cyfinfaza/RSC-LV3-HVBPS/(list of files, drawings)

Other design files:
RSC-LV3-HVBPS.dsn
