cyfinfaza/RSC-LV3-HVBPS/RSC-LV3-HVBPS.kicad_pcb

## KiCad design RSC-LV3-HVBPS.kicad_pcb (2026-06-22)

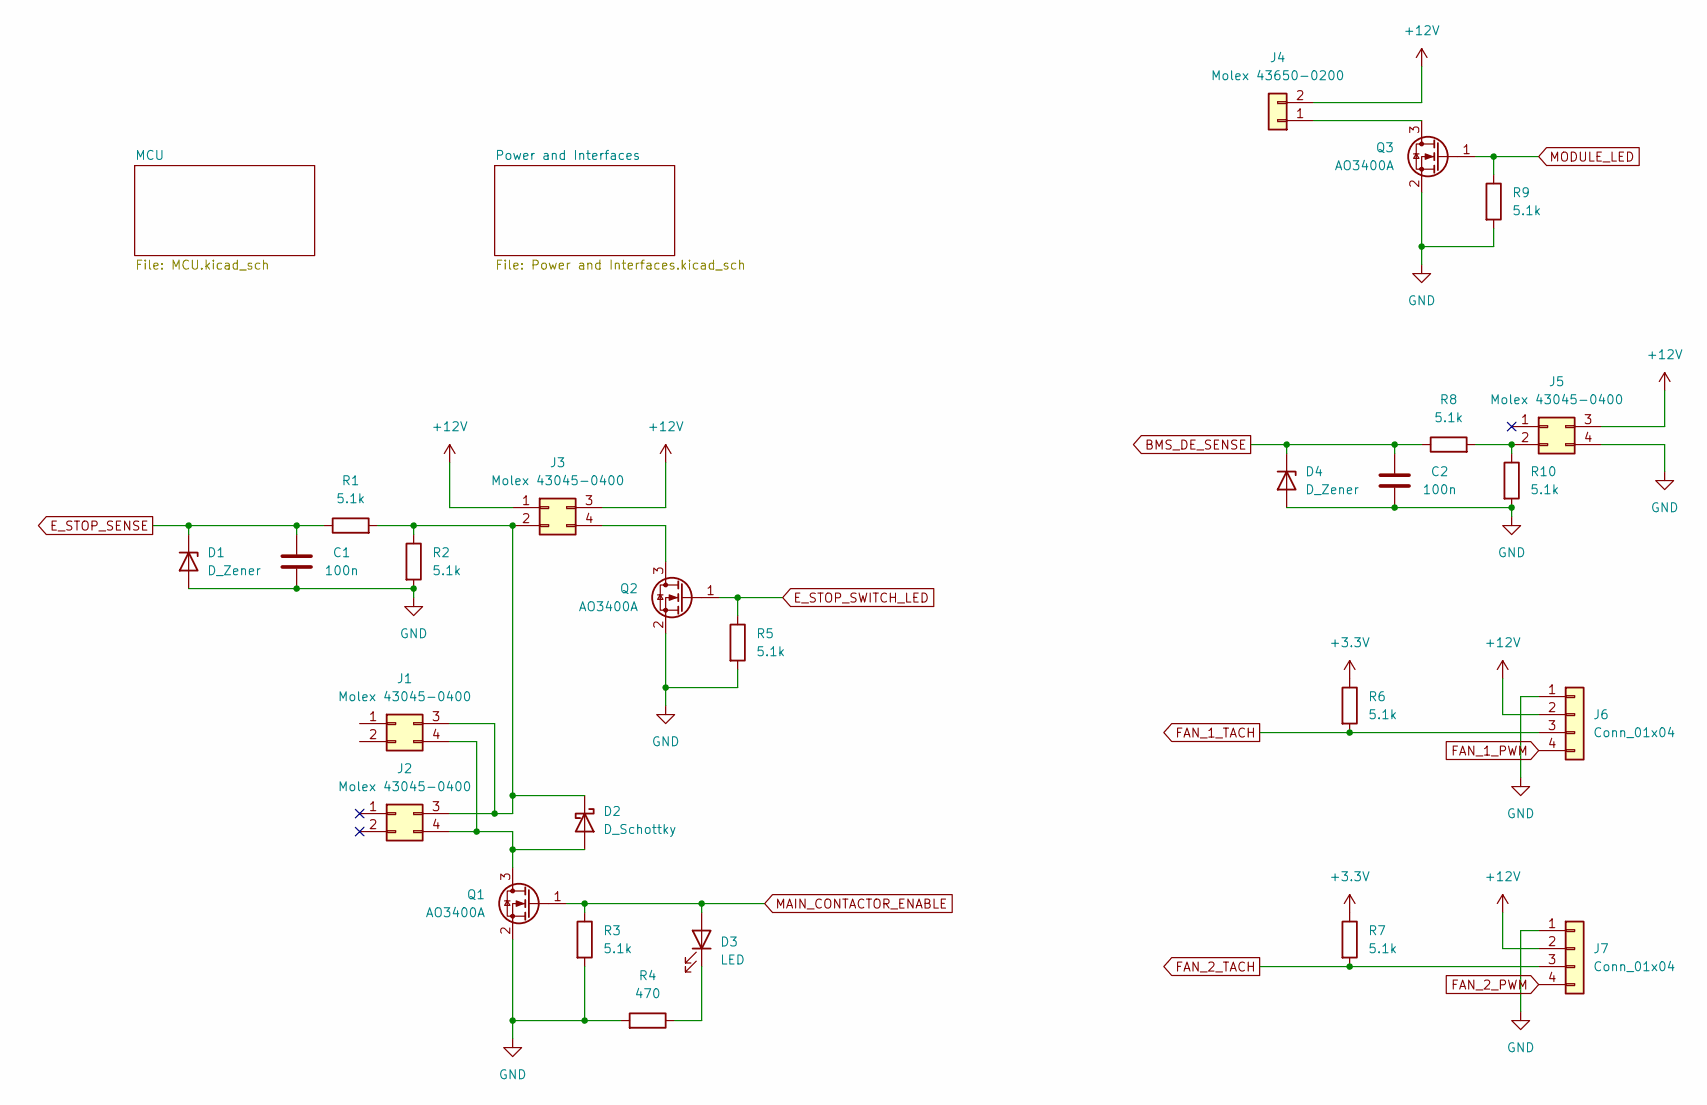
[picture p1: schematic RSC-LV3-HVBPS.kicad_sch]

Parts:
C1, C2: 100n; C_0603_1608Metric_Pad1.08x0.95mm_HandSolder
D1, D4: D_Zener; D_SOD-323_HandSoldering
D2: D_Schottky; D_SOD-123F
D3: LED; LED_0603_1608Metric_Pad1.05x0.95mm_HandSolder
J1, J2, J3, J5: Molex 43045-0400; Molex_Micro-Fit_3.0_43045-0412_2x02_P3.00mm_Vertical
J4: Molex 43650-0200; Molex_Micro-Fit_3.0_43650-0215_1x02_P3.00mm_Vertical
J6, J7: Conn_01x04; Molex_KK-254_AE-6410-04A_1x04_P2.54mm_Vertical
Q1, Q2, Q3: AO3400A; SOT-23
R1, R2, R3, R5, R6, R7, R8, R9, R10: 5.1k; R_0603_1608Metric_Pad0.98x0.95mm_HandSolder
R4: 470; R_0603_1608Metric_Pad0.98x0.95mm_HandSolder

Connections:
+3.3V: R6.1, R7.1; also elsewhere on the board
+12V: J3.1, J3.3, J4.2, J5.3, J6.2, J7.2; also elsewhere on the board
BMS_DE_SENSE: C2.1, D4.1 (K), R8.1; also elsewhere on the board
E_STOP_SENSE: C1.1, D1.1 (K), R1.1; also elsewhere on the board
E_STOP_SWITCH_LED: Q2.1 (G), R5.1; also elsewhere on the board
FAN_1_PWM: J6.4; also elsewhere on the board
FAN_1_TACH: J6.3, R6.2; also elsewhere on the board
FAN_2_PWM: J7.4; also elsewhere on the board
FAN_2_TACH: J7.3, R7.2; also elsewhere on the board
GND: C1.2, C2.2, D1.2 (A), D4.2 (A), J5.4, J6.1, J7.1, Q1.2 (S), Q2.2 (S), Q3.2 (S), R2.2, R3.2, R4.2, R5.2, R9.2, R10.2; also elsewhere on the board
MAIN_CONTACTOR_ENABLE: D3.2 (A), Q1.1 (G), R3.1; also elsewhere on the board
MODULE_LED: Q3.1 (G), R9.1; also elsewhere on the board
unnamed: D2.2 (A), J1.4, J2.4, Q1.3 (D)
unnamed: D2.1 (K), J1.3, J2.3, J3.2, R1.2, R2.1
unnamed: D3.1 (K), R4.1
unnamed: J3.4, Q2.3 (D)
unnamed: J4.1, Q3.3 (D)
unnamed: J5.2, R8.2, R10.1

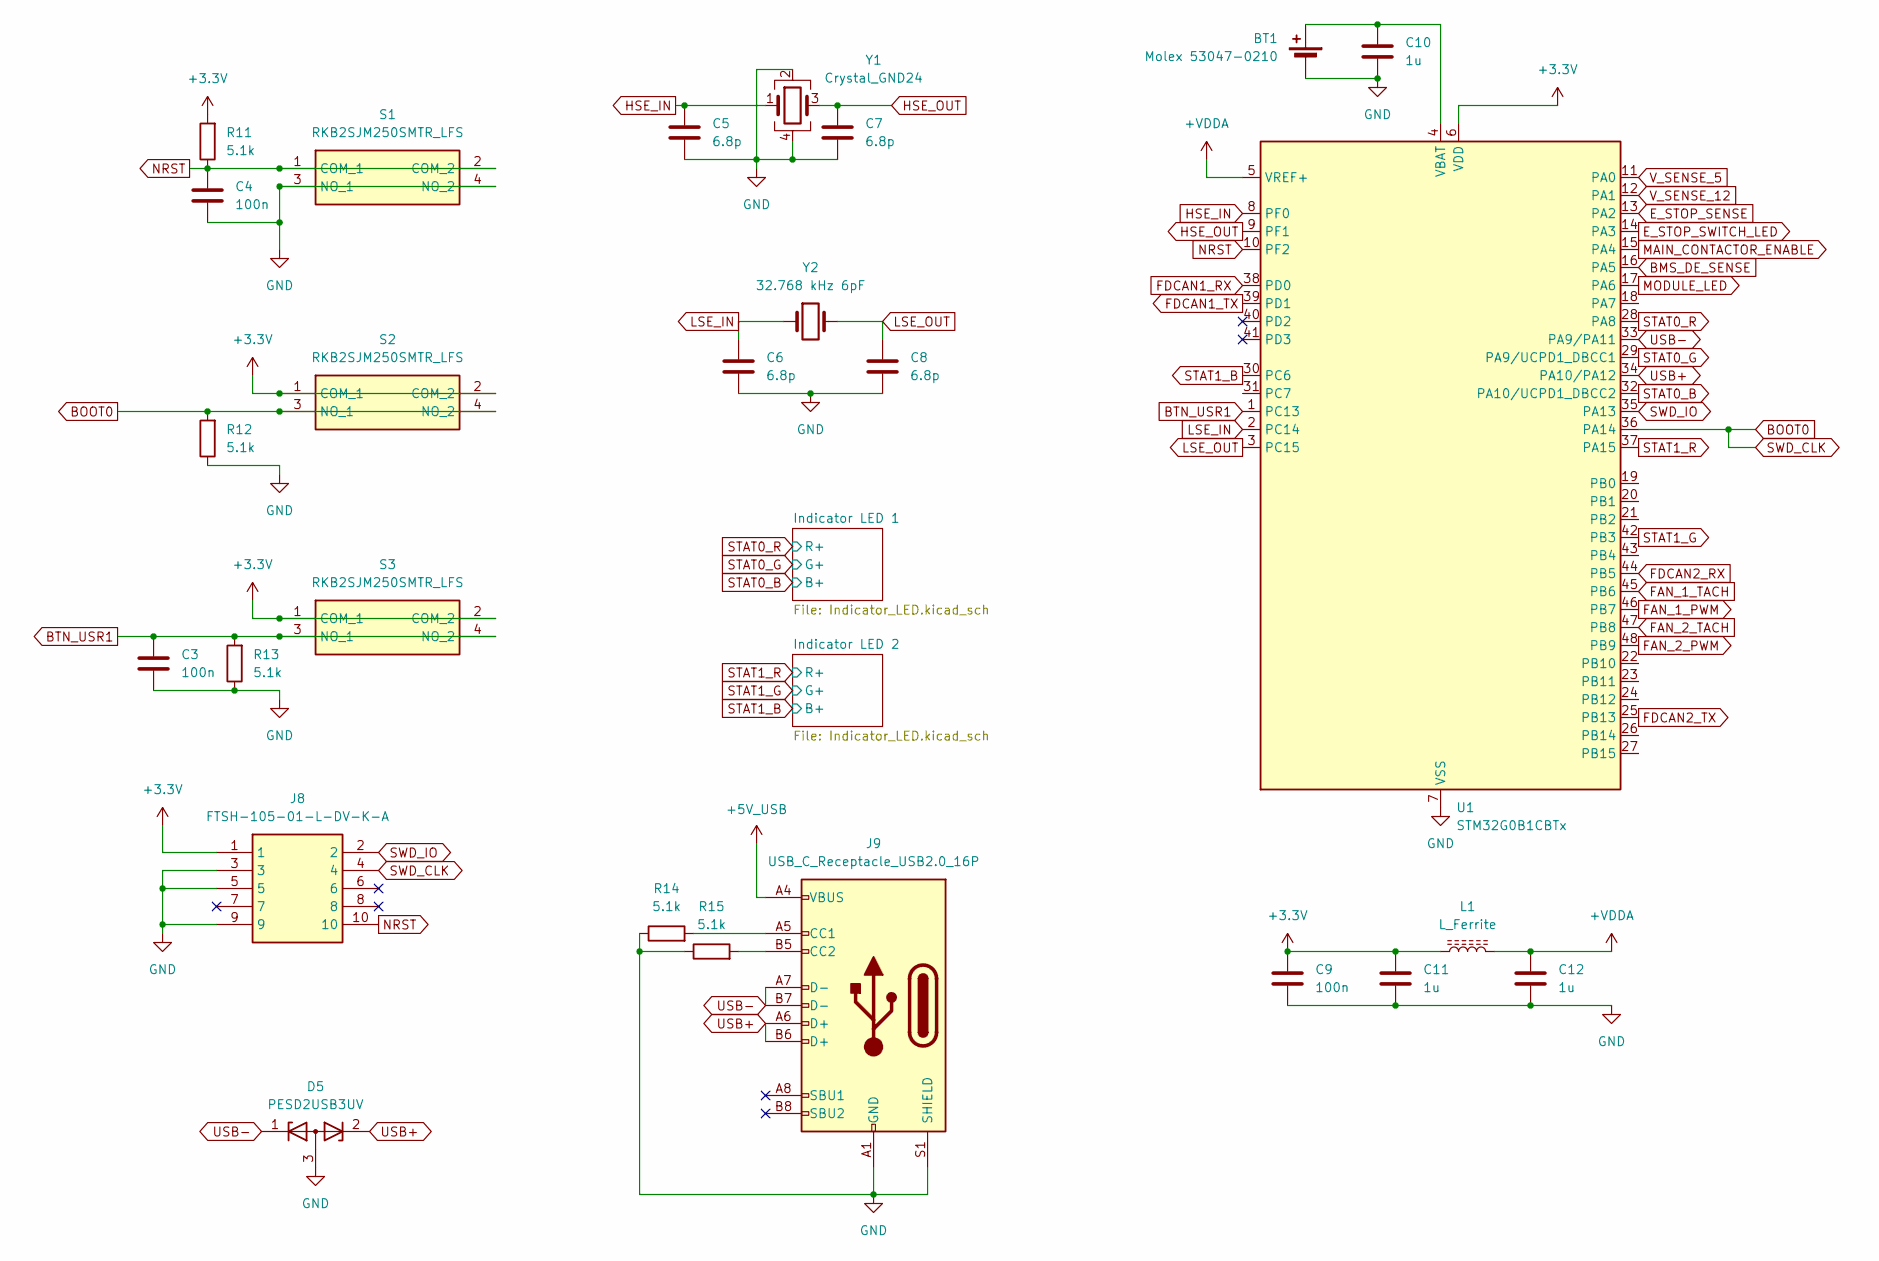
[picture p2: schematic MCU.kicad_sch]

Parts:
BT1: Molex 53047-0210; Molex_PicoBlade_53047-0210_1x02_P1.25mm_Vertical
C3, C4, C9: 100n; C_0603_1608Metric_Pad1.08x0.95mm_HandSolder
C5, C6, C7, C8: 6.8p; C_0603_1608Metric_Pad1.08x0.95mm_HandSolder
C10, C11, C12: 1u; C_0603_1608Metric_Pad1.08x0.95mm_HandSolder
D5: PESD2USB3UV; SOT-23W
J8: FTSH-105-01-L-DV-K-A; FTSH-105-XX-YYY-DV-K-A; Mouser Part Number 200-FTSH10501LDVKA
J9: USB_C_Receptacle_USB2.0_16P; USB_C_Receptacle_HRO_TYPE-C-31-M-12
L1: L_Ferrite; L_0603_1608Metric_Pad1.05x0.95mm_HandSolder
R11, R12, R13, R14, R15: 5.1k; R_0603_1608Metric_Pad0.98x0.95mm_HandSolder
S1, S2, S3: RKB2SJM250SMTR_LFS; RKB2SJM250SMTRLFS; Mouser Part Number 611-RKB2SJM250SMTRLF
U1: STM32G0B1CBTx; LQFP-48_7x7mm_P0.5mm
Y1: Crystal_GND24; Crystal_SMD_3225-4Pin_3.2x2.5mm
Y2: 32.768 kHz 6pF; Crystal_C26-LF_D2.1mm_L6.5mm_Horizontal

Connections:
+3.3V: C9.1, C11.1, J8.1, L1.1, R11.2, S2.1 (COM_1), S2.2 (COM_2), S3.1 (COM_1), S3.2 (COM_2), U1.6 (VDD); also elsewhere on the board
+5V_USB: J9.A4 (VBUS), J9.A9 (VBUS), J9.B4 (VBUS), J9.B9 (VBUS); also elsewhere on the board
+VDDA: C12.1, L1.2, U1.5 (VREF+)
BMS_DE_SENSE: U1.16 (PA5); also elsewhere on the board
BOOT0: J8.4, R12.2, S2.3 (NO_1), S2.4 (NO_2), U1.36 (PA14)
BTN_USR1: C3.1, R13.2, S3.3 (NO_1), S3.4 (NO_2), U1.1 (PC13)
E_STOP_SENSE: U1.13 (PA2); also elsewhere on the board
E_STOP_SWITCH_LED: U1.14 (PA3); also elsewhere on the board
FAN_1_PWM: U1.46 (PB7); also elsewhere on the board
FAN_1_TACH: U1.45 (PB6); also elsewhere on the board
FAN_2_PWM: U1.48 (PB9); also elsewhere on the board
FAN_2_TACH: U1.47 (PB8); also elsewhere on the board
FDCAN1_RX: U1.38 (PD0); also elsewhere on the board
FDCAN1_TX: U1.39 (PD1); also elsewhere on the board
FDCAN2_RX: U1.44 (PB5); also elsewhere on the board
FDCAN2_TX: U1.25 (PB13); also elsewhere on the board
GND: BT1.2 (-), C3.2, C4.2, C5.2, C6.2, C7.2, C8.2, C9.2, C10.2, C11.2, C12.2, D5.3 (A), J8.3, J8.5, J8.9, J9.A1 (GND), J9.A12 (GND), J9.B1 (GND), J9.B12 (GND), J9.S1 (SHIELD), R12.1, R13.1, R14.1, R15.1, S1.3 (NO_1), S1.4 (NO_2), U1.7 (VSS), Y1.2, Y1.4; also elsewhere on the board
HSE_IN: C5.1, U1.8 (PF0), Y1.1
HSE_OUT: C7.1, U1.9 (PF1), Y1.3
LSE_IN: C6.1, U1.2 (PC14), Y2.1
LSE_OUT: C8.1, U1.3 (PC15), Y2.2
MAIN_CONTACTOR_ENABLE: U1.15 (PA4); also elsewhere on the board
MODULE_LED: U1.17 (PA6); also elsewhere on the board
NRST: C4.1, J8.10, R11.1, S1.1 (COM_1), S1.2 (COM_2), U1.10 (PF2)
unnamed: BT1.1 (+), C10.1, U1.4 (VBAT)
unnamed: J9.A5 (CC1), R14.2
unnamed: J9.B5 (CC2), R15.2
STAT0_B: U1.32 (PA10/UCPD1_DBCC2); also elsewhere on the board
STAT0_G: U1.29 (PA9/UCPD1_DBCC1); also elsewhere on the board
STAT0_R: U1.28 (PA8); also elsewhere on the board
STAT1_B: U1.30 (PC6); also elsewhere on the board
STAT1_G: U1.42 (PB3); also elsewhere on the board
STAT1_R: U1.37 (PA15); also elsewhere on the board
SWD_IO: J8.2, U1.35 (PA13)
USB+: D5.2 (K), J9.A6 (D+), J9.B6 (D+), U1.34 (PA10/PA12)
USB-: D5.1 (K), J9.A7 (D-), J9.B7 (D-), U1.33 (PA9/PA11)
V_SENSE_5: U1.11 (PA0); also elsewhere on the board
V_SENSE_12: U1.12 (PA1); also elsewhere on the board

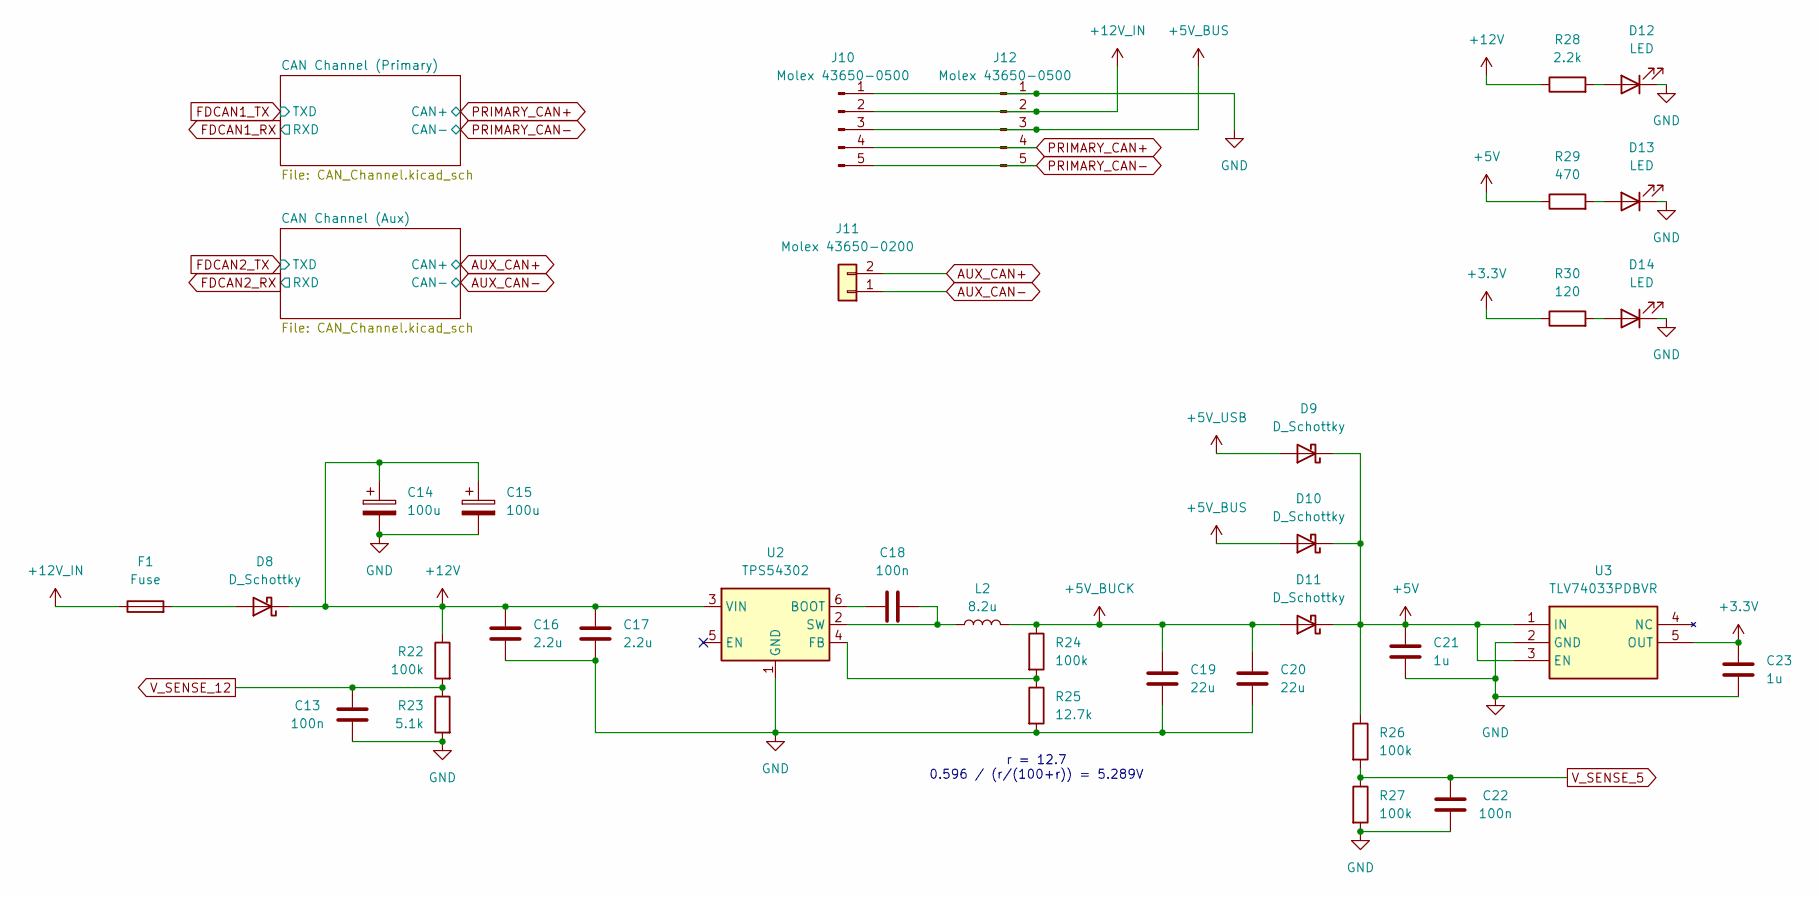
[picture p3: schematic Power and Interfaces.kicad_sch]

Parts:
C13, C18, C22: 100n; C_0603_1608Metric_Pad1.08x0.95mm_HandSolder
C14, C15: 100u; CP_Radial_D6.3mm_P2.50mm
C16, C17: 2.2u; C_0603_1608Metric_Pad1.08x0.95mm_HandSolder
C19, C20: 22u; C_1206_3216Metric_Pad1.33x1.80mm_HandSolder
C21, C23: 1u; C_0603_1608Metric_Pad1.08x0.95mm_HandSolder
D8: D_Schottky; D_SMA
D9, D10, D11: D_Schottky; D_SOD-123F
D12, D13, D14: LED; LED_0603_1608Metric_Pad1.05x0.95mm_HandSolder
F1: Fuse; Fuseholder_Blade_Mini_Keystone_3568
J10, J12: Molex 43650-0500; Molex_Micro-Fit_3.0_43650-0515_1x05_P3.00mm_Vertical
J11: Molex 43650-0200; Molex_Micro-Fit_3.0_43650-0215_1x02_P3.00mm_Vertical
L2: 8.2u; L_Abracon_ASPI-4030S
R22, R24, R26, R27: 100k; R_0603_1608Metric_Pad0.98x0.95mm_HandSolder
R23: 5.1k; R_0603_1608Metric_Pad0.98x0.95mm_HandSolder
R25: 12.7k; R_0603_1608Metric_Pad0.98x0.95mm_HandSolder
R28: 2.2k; R_0603_1608Metric_Pad0.98x0.95mm_HandSolder
R29: 470; R_0603_1608Metric_Pad0.98x0.95mm_HandSolder
R30: 120; R_0603_1608Metric_Pad0.98x0.95mm_HandSolder
U2: TPS54302; SOT-23-6_Handsoldering
U3: TLV74033PDBVR; SOT95P280X145-5N; Mouser Part Number 595-TLV74033PDBVR

Connections:
+3.3V: C23.1, R30.1, U3.5 (OUT); also elsewhere on the board
+5V: C21.1, D9.1 (K), D10.1 (K), D11.1 (K), R26.1, R29.1, U3.1 (IN), U3.3 (EN); also elsewhere on the board
+5V_BUCK: C19.1, C20.1, D11.2 (A), L2.2, R24.1
+5V_BUS: D10.2 (A), J10.3, J12.3
+5V_USB: D9.2 (A); also elsewhere on the board
+12V: C14.1, C15.1, C16.1, C17.1, D8.1 (K), R22.1, R28.1, U2.3 (VIN); also elsewhere on the board
+12V_IN: F1.1, J10.2, J12.2
AUX_CAN+: J11.2; also elsewhere on the board
AUX_CAN-: J11.1; also elsewhere on the board
GND: C13.2, C14.2, C15.2, C16.2, C17.2, C19.2, C20.2, C21.2, C22.2, C23.2, D12.1 (K), D13.1 (K), D14.1 (K), J10.1, J12.1, R23.2, R25.2, R27.2, U2.1 (GND), U3.2 (GND); also elsewhere on the board
unnamed: D8.2 (A), F1.2
unnamed: D12.2 (A), R28.2
unnamed: D13.2 (A), R29.2
unnamed: D14.2 (A), R30.2
unnamed: C18.1, U2.6 (BOOT)
unnamed: R24.2, R25.1, U2.4 (FB)
unnamed: C18.2, L2.1, U2.2 (SW)
PRIMARY_CAN+: J10.4, J12.4; also elsewhere on the board
PRIMARY_CAN-: J10.5, J12.5; also elsewhere on the board
V_SENSE_5: C22.1, R26.2, R27.1; also elsewhere on the board
V_SENSE_12: C13.1, R22.2, R23.1; also elsewhere on the board

Notes on the sheet:
r = 12.7 0.596 / (r/(100+r)) = 5.289V

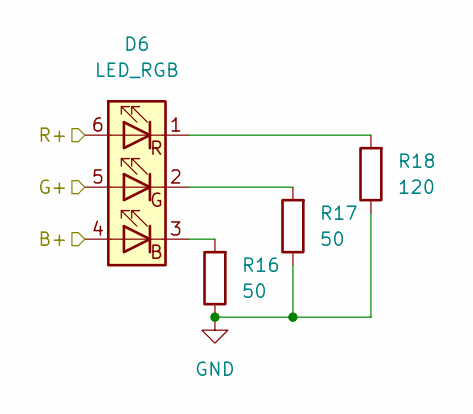
[picture p4: schematic Indicator_LED.kicad_sch]

Parts:
D6: LED_RGB; LED_RGB_5050-6
R16, R17: 50; R_0603_1608Metric_Pad0.98x0.95mm_HandSolder
R18: 120; R_0603_1608Metric_Pad0.98x0.95mm_HandSolder

Connections:
GND: R16.1, R17.1, R18.1; also elsewhere on the board
unnamed: D6.3 (BK), R16.2
unnamed: D6.2 (GK), R17.2
unnamed: D6.1 (RK), R18.2
STAT0_B: D6.4 (BA); also elsewhere on the board
STAT0_G: D6.5 (GA); also elsewhere on the board
STAT0_R: D6.6 (RA); also elsewhere on the board

Parts of its further copies:
D7: LED_RGB; LED_RGB_5050-6
R19, R20: 50; R_0603_1608Metric_Pad0.98x0.95mm_HandSolder
R21: 120; R_0603_1608Metric_Pad0.98x0.95mm_HandSolder

Connections of its further copies:
GND: R19.1, R20.1, R21.1; also elsewhere on the board
unnamed: D7.3 (BK), R19.2
unnamed: D7.2 (GK), R20.2
unnamed: D7.1 (RK), R21.2
STAT1_B: D7.4 (BA); also elsewhere on the board
STAT1_G: D7.5 (GA); also elsewhere on the board
STAT1_R: D7.6 (RA); also elsewhere on the board

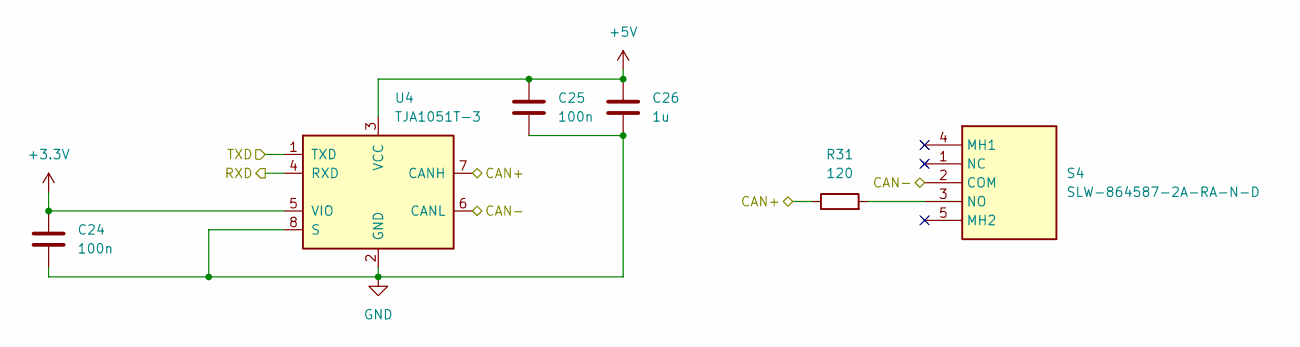
[picture p5: schematic CAN_Channel.kicad_sch]

Parts:
C24, C25: 100n; C_0603_1608Metric_Pad1.08x0.95mm_HandSolder
C26: 1u; C_0603_1608Metric_Pad1.08x0.95mm_HandSolder
R31: 120; R_0603_1608Metric_Pad0.98x0.95mm_HandSolder
S4: SLW-864587-2A-RA-N-D; SLW8645872ARAND; Mouser Part Number 179-SLW8645872ARAND
U4: TJA1051T-3; SOIC-8_3.9x4.9mm_P1.27mm

Connections:
+3.3V: C24.1, U4.5 (VIO); also elsewhere on the board
+5V: C25.1, C26.1, U4.3 (VCC); also elsewhere on the board
FDCAN1_RX: U4.4 (RXD); also elsewhere on the board
FDCAN1_TX: U4.1 (TXD); also elsewhere on the board
GND: C24.2, C25.2, C26.2, U4.2 (GND), U4.8 (S); also elsewhere on the board
unnamed: R31.2, S4.3 (NO)
PRIMARY_CAN+: R31.1, U4.7 (CANH); also elsewhere on the board
PRIMARY_CAN-: S4.2 (COM), U4.6 (CANL); also elsewhere on the board

Parts of its further copies:
C27, C28: 100n; C_0603_1608Metric_Pad1.08x0.95mm_HandSolder
C29: 1u; C_0603_1608Metric_Pad1.08x0.95mm_HandSolder
R32: 120; R_0603_1608Metric_Pad0.98x0.95mm_HandSolder
S5: SLW-864587-2A-RA-N-D; SLW8645872ARAND; Mouser Part Number 179-SLW8645872ARAND
U5: TJA1051T-3; SOIC-8_3.9x4.9mm_P1.27mm

Connections of its further copies:
+3.3V: C27.1, U5.5 (VIO); also elsewhere on the board
+5V: C28.1, C29.1, U5.3 (VCC); also elsewhere on the board
AUX_CAN+: R32.1, U5.7 (CANH); also elsewhere on the board
AUX_CAN-: S5.2 (COM), U5.6 (CANL); also elsewhere on the board
FDCAN2_RX: U5.4 (RXD); also elsewhere on the board
FDCAN2_TX: U5.1 (TXD); also elsewhere on the board
GND: C27.2, C28.2, C29.2, U5.2 (GND), U5.8 (S); also elsewhere on the board
unnamed: R32.2, S5.3 (NO)

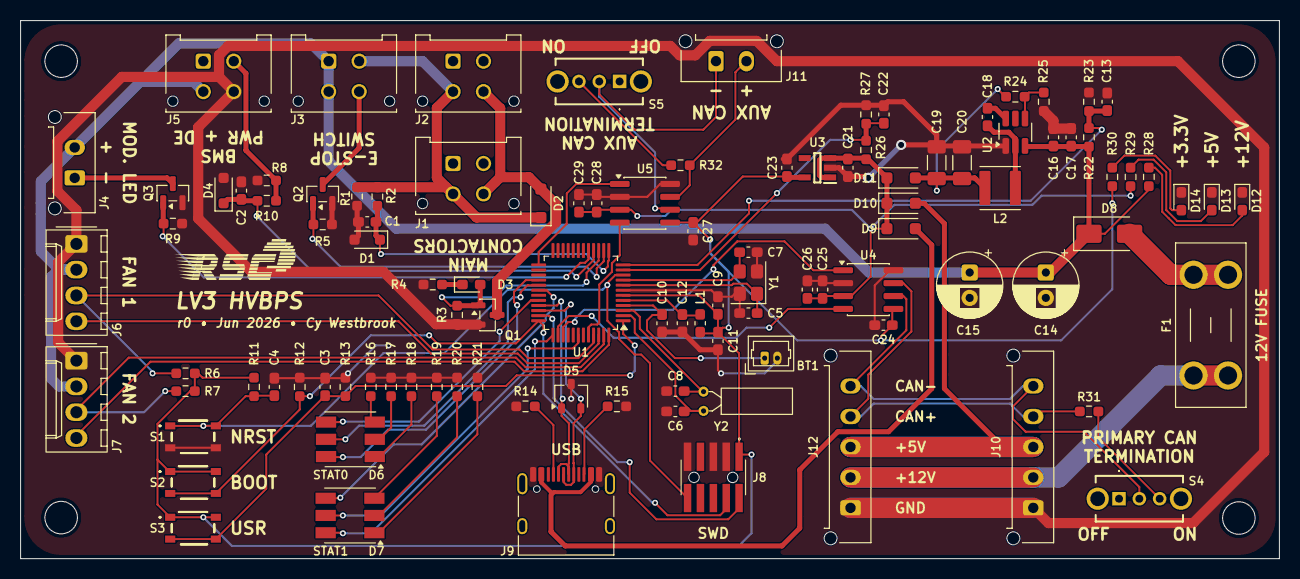
[picture p6: board RSC-LV3-HVBPS.kicad_pcb from above]

Board: 2 copper layers, 124.0 x 53.0 mm, 106 parts (0 on the bottom side), 68 nets.
