cyfinfaza/RSC-LV3-HVBPS/RSC-LV3-SwitchSense-CubeMX/RSC-LV3-SwitchSense-CubeMX.ioc

Mcu.UserName=STM32G0B1CBTx
PA0.GPIO_Label=V_SENSE_5
PA0.Signal=ADC1_IN0
PA1.GPIO_Label=V_SENSE_12
PA1.Signal=ADC1_IN1
PA10.GPIO_Label=STAT0_B
PA10.Signal=S_TIM1_CH3
PA13.Signal=SYS_SWDIO
PA14-BOOT0.Signal=SYS_SWCLK
PA15.GPIO_Label=STAT1_R
PA15.Signal=S_TIM2_CH1_ETR
PA2.GPIO_Label=IN_1
PA2.Signal=ADC1_IN2
PA3.GPIO_Label=IN_2
PA3.Signal=ADC1_IN3
PA4.GPIO_Label=IN_3
PA4.Signal=ADC1_IN4
PA5.GPIO_Label=IN_4
PA5.Signal=ADC1_IN5
PA6.GPIO_Label=IN_5
PA6.Signal=ADC1_IN6
PA7.GPIO_Label=IN_6
PA7.Signal=ADC1_IN7
PA8.GPIO_Label=STAT0_R
PA8.Signal=S_TIM1_CH1
PA9.GPIO_Label=STAT0_G
PA9.Signal=S_TIM1_CH2
PB0.GPIO_Label=OUT_3
PB0.Signal=S_TIM3_CH3
PB1.GPIO_Label=OUT_4
PB1.Signal=S_TIM3_CH4
PB10.GPIO_Label=IN_8
PB10.Signal=ADC1_IN11
PB11.GPIO_Label=IN_9
PB11.Signal=ADC1_IN15
PB12.GPIO_Label=IN_10
PB12.Signal=ADC1_IN16
PB13.Signal=FDCAN2_TX
PB14.GPIO_Label=OUT_9
PB14.Signal=S_TIM15_CH1
PB15.GPIO_Label=OUT_10
PB15.Signal=S_TIM15_CH2
PB2.GPIO_Label=IN_7
PB2.Signal=ADC1_IN10
PB3.GPIO_Label=STAT1_G
PB3.Signal=S_TIM2_CH2
PB4.GPIO_Label=OUT_1
PB4.Signal=S_TIM3_CH1
PB5.Signal=FDCAN2_RX
PB6.GPIO_Label=OUT_5
PB6.Signal=S_TIM4_CH1
PB7.GPIO_Label=OUT_6
PB7.Signal=S_TIM4_CH2
PB8.GPIO_Label=OUT_7
PB8.Signal=S_TIM4_CH3
PB9.GPIO_Label=OUT_8
PB9.Signal=S_TIM4_CH4
PC13.GPIO_Label=BTN_USR
PC13.Signal=GPIO_Input
PC6.GPIO_Label=STAT1_B
PC6.Signal=S_TIM2_CH3
PC7.GPIO_Label=OUT_2
PC7.Signal=S_TIM3_CH2
PD0.Signal=FDCAN1_RX
PD1.Signal=FDCAN1_TX
