cyfinfaza/RSC-LV3-HVBPS/(commit log)

2026-05-25 updated pinout, begin layout
    [CAN_Channel.kicad_sch, Indicator_LED.kicad_sch, Inputs.kicad_sch, MCU.kicad_sch, Power and Interfaces.kicad_sch, RSC-LV3-SwitchSense.kicad_pcb, RSC-LV3-SwitchSense.kicad_sch, SwitchSense.kicad_sch]
2026-05-26 more layout work
    [RSC-LV3-SwitchSense.kicad_pcb]
2026-05-30 more work on layout
    [MCU.kicad_sch, RSC-LV3-SwitchSense.kicad_pcb]
2026-06-03 add second CAN and backup domain components
    [CAN_Channel.kicad_sch, MCU.kicad_sch, Power and Interfaces.kicad_sch, RSC-LV3-SwitchSense.kicad_pcb]
2026-06-03 dual H/V compatible Molex footprints, corrected STM32 pinout
    [MCU.kicad_sch, Power and Interfaces.kicad_sch, RSC-LV3-SwitchSense.kicad_pcb, SwitchSense.kicad_sch]
2026-06-03 initial routing
    [RSC-LV3-SwitchSense.kicad_pcb]
2026-06-03 more non-autorouting adjustments
    [RSC-LV3-SwitchSense.dsn, RSC-LV3-SwitchSense.kicad_pcb, freerouting.dsn, temp-freerouting.dsn]
2026-06-04 initial complete route
    [RSC-LV3-SwitchSense.kicad_pcb, freerouting.dsn, temp-freerouting.dsn]
2026-06-06 silkscreen work
    [RSC-LV3-SwitchSense.kicad_pcb]
2026-06-06 more silkscreen and routing cleanup
    [RSC-LV3-SwitchSense.kicad_pcb]
2026-06-14 add zener diodes to inputs
    [RSC-LV3-SwitchSense.kicad_pcb, SwitchSense.kicad_sch]
2026-06-16 silkscreen tweaks
    [RSC-LV3-SwitchSense.kicad_pcb]
2026-06-16 add electrolytic capacitors and minor layout and silkscreen adjustments
    [Power and Interfaces.kicad_sch, RSC-LV3-SwitchSense.kicad_pcb]
2026-06-20 minor layout and silkscreen changes
    [RSC-LV3-SwitchSense.kicad_pcb, bom.csv, designators.csv, positions.csv]
2026-06-20 copy from SwitchSense, update schematic, begin redoing layout
    [CAN_Channel.kicad_sch, Indicator_LED.kicad_sch, Inputs.kicad_sch, MCU.kicad_sch, Power and Interfaces.kicad_sch, RSC-LV3-HVBPS.dsn, RSC-LV3-HVBPS.kicad_pcb, RSC-LV3-HVBPS.kicad_sch]
2026-06-21 initial layout
    [MCU.kicad_sch, Power and Interfaces.kicad_sch, RSC-LV3-HVBPS.kicad_pcb, RSC-LV3-HVBPS.kicad_sch]
2026-06-21 more layout and some initial routing
    [RSC-LV3-HVBPS.kicad_pcb, RSC-LV3-HVBPS.kicad_sch]
2026-06-21 full layout routing and silkscreen
    [MCU.kicad_sch, RSC-LV3-HVBPS.kicad_pcb]
2026-06-22 r0 final
    [CAN_Channel.kicad_sch, Indicator_LED.kicad_sch, MCU.kicad_sch, Power and Interfaces.kicad_sch, RSC-LV3-HVBPS.kicad_pcb, RSC-LV3-HVBPS.kicad_sch, bom.csv, designators.csv]
